Disasm/usb-tester/hardware/usb-tester.kicad_pcb

## KiCad design hardware/usb-tester.kicad_pcb (2020-05-18)

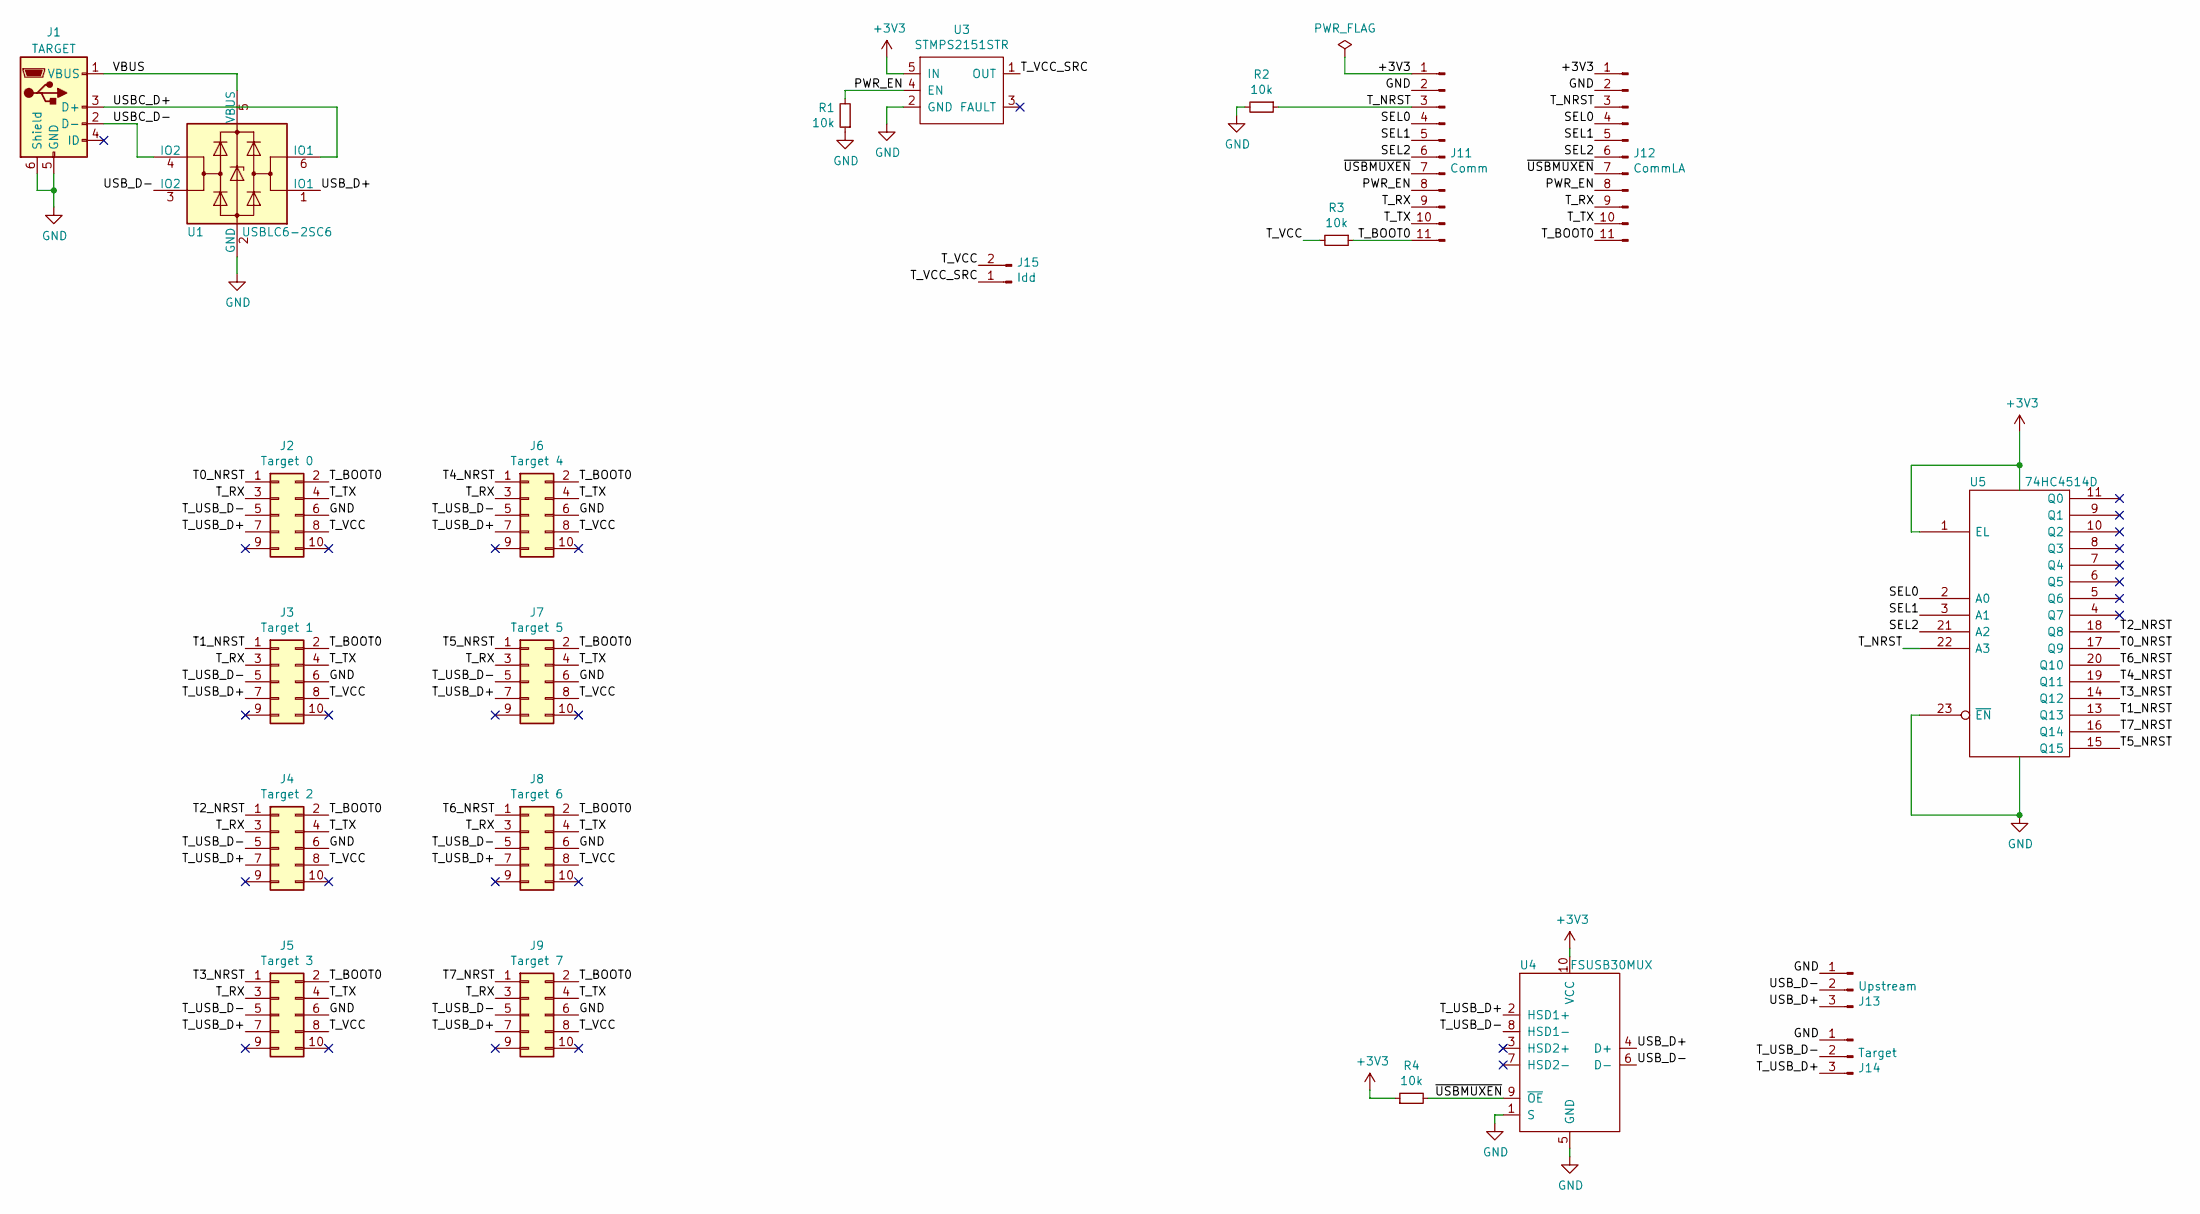
[picture p1: schematic usb-tester.sch]

Parts:
J1: TARGET; USB_Micro-B_Molex-105017-0001
J2: Target 0; PinSocket_2x05_P2.54mm_Vertical_Reversed
J3: Target 1; PinSocket_2x05_P2.54mm_Vertical_Reversed
J4: Target 2; PinSocket_2x05_P2.54mm_Vertical_Reversed
J5: Target 3; PinSocket_2x05_P2.54mm_Vertical_Reversed
J6: Target 4; PinSocket_2x05_P2.54mm_Vertical_Reversed
J7: Target 5; PinSocket_2x05_P2.54mm_Vertical_Reversed
J8: Target 6; PinSocket_2x05_P2.54mm_Vertical_Reversed
J9: Target 7; PinSocket_2x05_P2.54mm_Vertical_Reversed
J11: Comm; PinHeader_1x11_P2.54mm_Vertical
J12: CommLA; PinHeader_1x11_P2.54mm_Vertical
J13: Upstream; PinHeader_1x03_P2.54mm_Vertical
J14: Target; PinHeader_1x03_P2.54mm_Vertical
J15: Idd; PinHeader_1x02_P2.54mm_Vertical
R1, R2, R3, R4: 10k; R_1206_3216Metric_Pad1.42x1.75mm_HandSolder
U1: USBLC6-2SC6; SOT-23-6
U3: STMPS2151STR; SOT-23-5
U4: FSUSB30MUX; MSOP-10_3x3mm_P0.5mm
U5: 74HC4514D; SOIC-24W_7.5x15.4mm_P1.27mm

Connections:
+3V3: J11.1, J12.1, R4.1, U3.5 (IN), U4.10 (VCC), U5.1 (EL), U5.24 (Vdd)
/PWR_EN: J11.8, J12.8, R1.2, U3.4 (EN)
/SEL0: J11.4, J12.4, U5.2 (A0)
/SEL1: J11.5, J12.5, U5.3 (A1)
/SEL2: J11.6, J12.6, U5.21 (A2)
/T0_NRST: J2.1, U5.17 (Q9)
/T1_NRST: J3.1, U5.13 (Q13)
/T2_NRST: J4.1, U5.18 (Q8)
/T3_NRST: J5.1, U5.14 (Q12)
/T4_NRST: J6.1, U5.19 (Q11)
/T5_NRST: J7.1, U5.15 (Q15)
/T6_NRST: J8.1, U5.20 (Q10)
/T7_NRST: J9.1, U5.16 (Q14)
/T_BOOT0: J2.2, J3.2, J4.2, J5.2, J6.2, J7.2, J8.2, J9.2, J11.11, J12.11, R3.1
/T_NRST: J11.3, J12.3, R2.1, U5.22 (A3)
/T_RX: J2.3, J3.3, J4.3, J5.3, J6.3, J7.3, J8.3, J9.3, J11.9, J12.9
/T_TX: J2.4, J3.4, J4.4, J5.4, J6.4, J7.4, J8.4, J9.4, J11.10, J12.10
/T_USB_D+: J2.7, J3.7, J4.7, J5.7, J6.7, J7.7, J8.7, J9.7, J14.3, U4.2 (HSD1+)
/T_USB_D-: J2.5, J3.5, J4.5, J5.5, J6.5, J7.5, J8.5, J9.5, J14.2, U4.8 (HSD1-)
/T_VCC: J2.8, J3.8, J4.8, J5.8, J6.8, J7.8, J8.8, J9.8, J15.2, R3.2
/T_VCC_SRC: J15.1, U3.1 (OUT)
/USBC_D+: J1.3 (D+), U1.6 (IO1)
/USBC_D-: J1.2 (D-), U1.4 (IO2)
/USB_D+: J13.3, U1.1 (IO1), U4.4 (D+)
/USB_D-: J13.2, U1.3 (IO2), U4.6 (D-)
/VBUS: J1.1 (VBUS), U1.5 (VBUS)
/~USBMUXEN: J11.7, J12.7, R4.2, U4.9 (~OE)
GND: J1.5 (GND), J1.6 (Shield), J2.6, J3.6, J4.6, J5.6, J6.6, J7.6, J8.6, J9.6, J11.2, J12.2, J13.1, J14.1, R1.1, R2.2, U1.2 (GND), U3.2 (GND), U4.1 (S), U4.5 (GND), U5.12 (Vss), U5.23 (~EN)

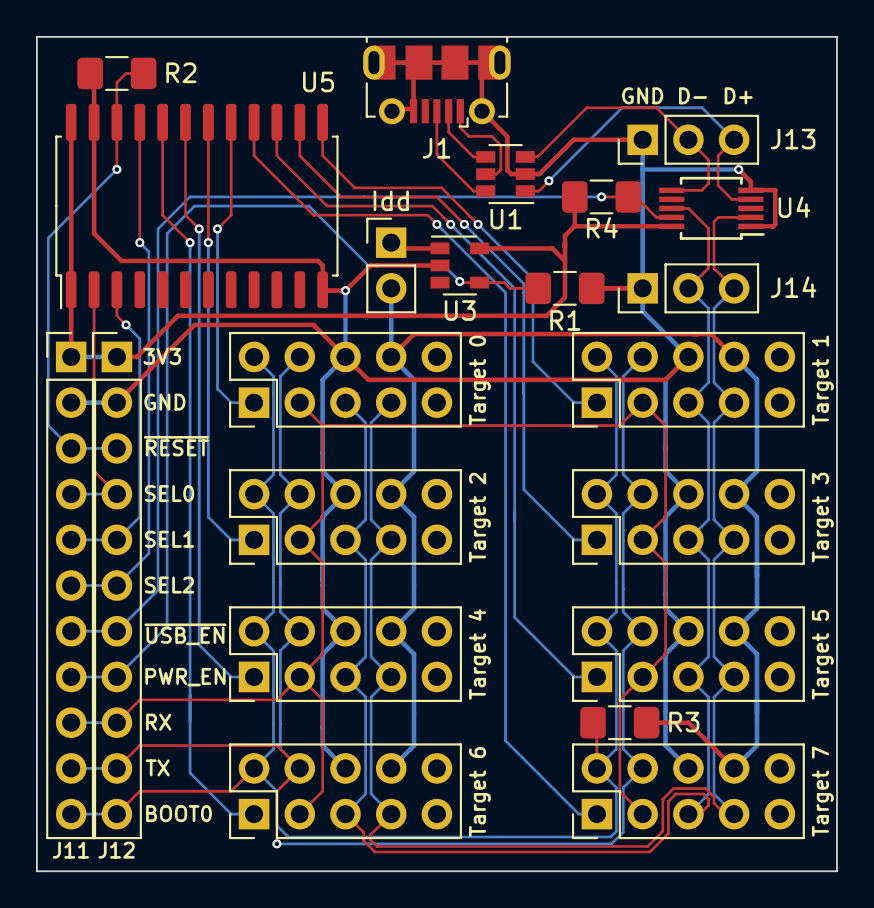
[picture p2: board usb-tester.kicad_pcb from above]

Board: 2 copper layers, 44.5 x 46.4 mm, 22 parts (0 on the bottom side), 28 nets.
