Disasm/usb-tester/hardware/mod-lqfp48.kicad_pcb

## KiCad design hardware/mod-lqfp48.kicad_pcb (2020-02-24)

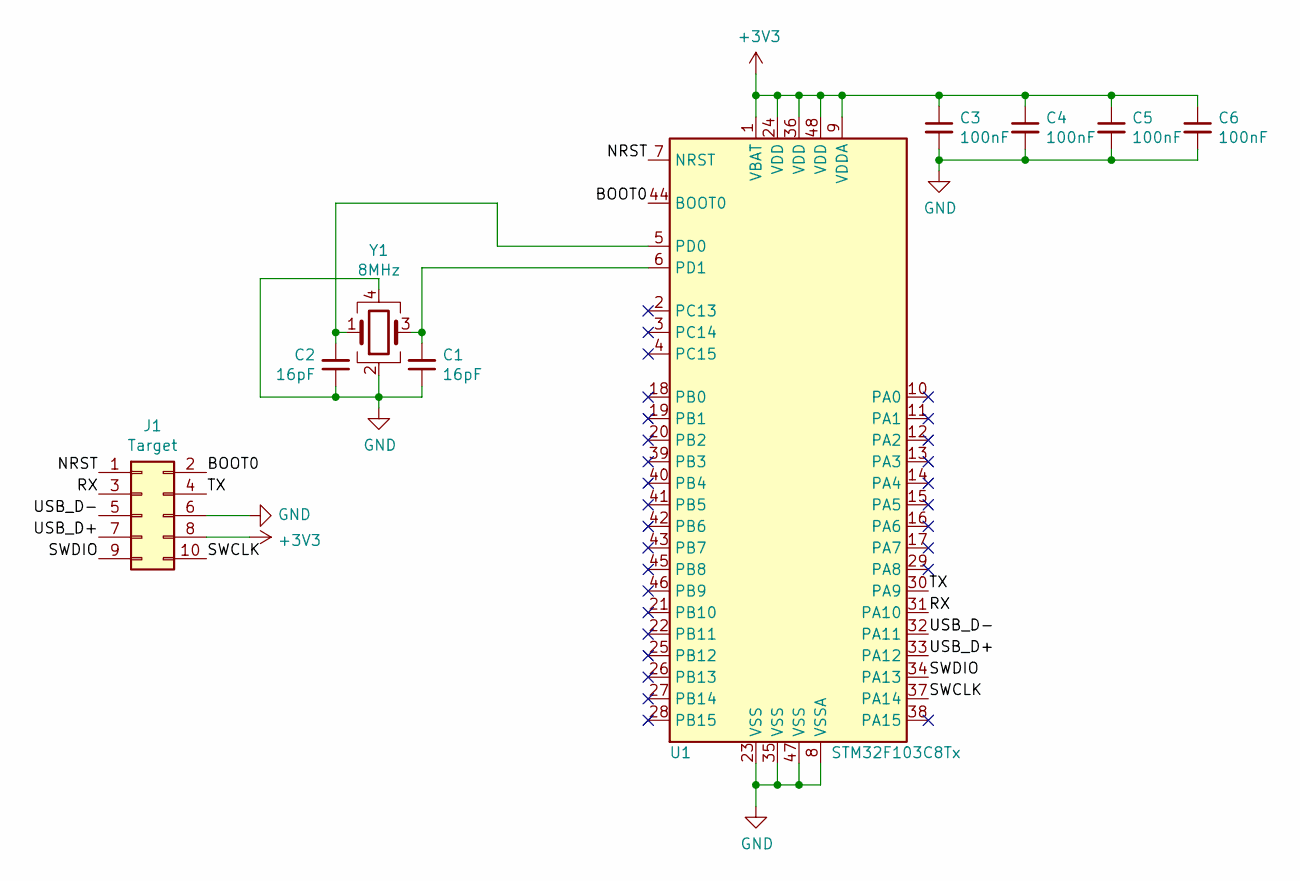
[picture p3: schematic mod-lqfp48.sch]

Parts:
C1, C2: 16pF; C_0805_2012Metric_Pad1.15x1.40mm_HandSolder
C3, C4, C5, C6: 100nF; C_0805_2012Metric_Pad1.15x1.40mm_HandSolder
J1: Target; BH-10-Edge
U1: STM32F103C8Tx; LQFP-48_7x7mm_P0.5mm
Y1: 8MHz; Crystal_SMD_5032-4Pin_5.0x3.2mm

Connections:
+3V3: C3.1, C4.1, C5.1, C6.1, J1.8, U1.1 (VBAT), U1.9 (VDDA), U1.24 (VDD), U1.36 (VDD), U1.48 (VDD)
/BOOT0: J1.2, U1.44 (BOOT0)
/NRST: J1.1, U1.7 (NRST)
/RX: J1.3, U1.31 (PA10)
/SWCLK: J1.10, U1.37 (PA14)
/SWDIO: J1.9, U1.34 (PA13)
/TX: J1.4, U1.30 (PA9)
/USB_D+: J1.7, U1.33 (PA12)
/USB_D-: J1.5, U1.32 (PA11)
GND: C1.1, C2.1, C3.2, C4.2, C5.2, C6.2, J1.6, U1.8 (VSSA), U1.23 (VSS), U1.35 (VSS), U1.47 (VSS), Y1.2, Y1.4
unnamed: C1.2, U1.6 (PD1), Y1.3
unnamed: C2.2, U1.5 (PD0), Y1.1

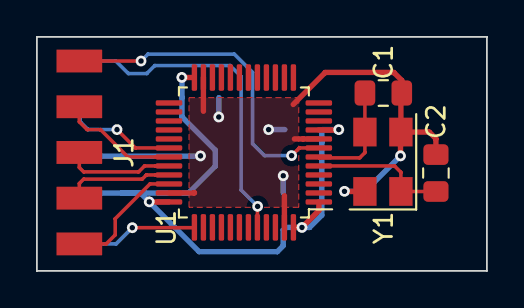
[picture p4: board mod-lqfp48.kicad_pcb from above]

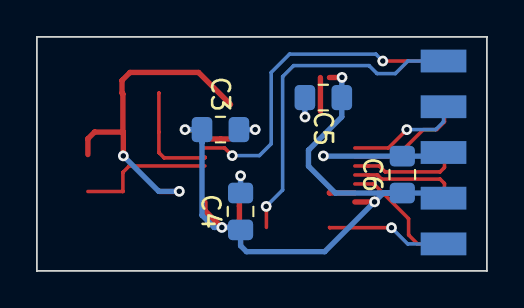
[picture p5: board mod-lqfp48.kicad_pcb from below]

Board: 2 copper layers, 25.0 x 13.0 mm, 9 parts (4 on the bottom side), 12 nets.
