Disasm/usb-tester/hardware/mod-lqfp64.kicad_pcb

## KiCad design hardware/mod-lqfp64.kicad_pcb (2020-02-24)

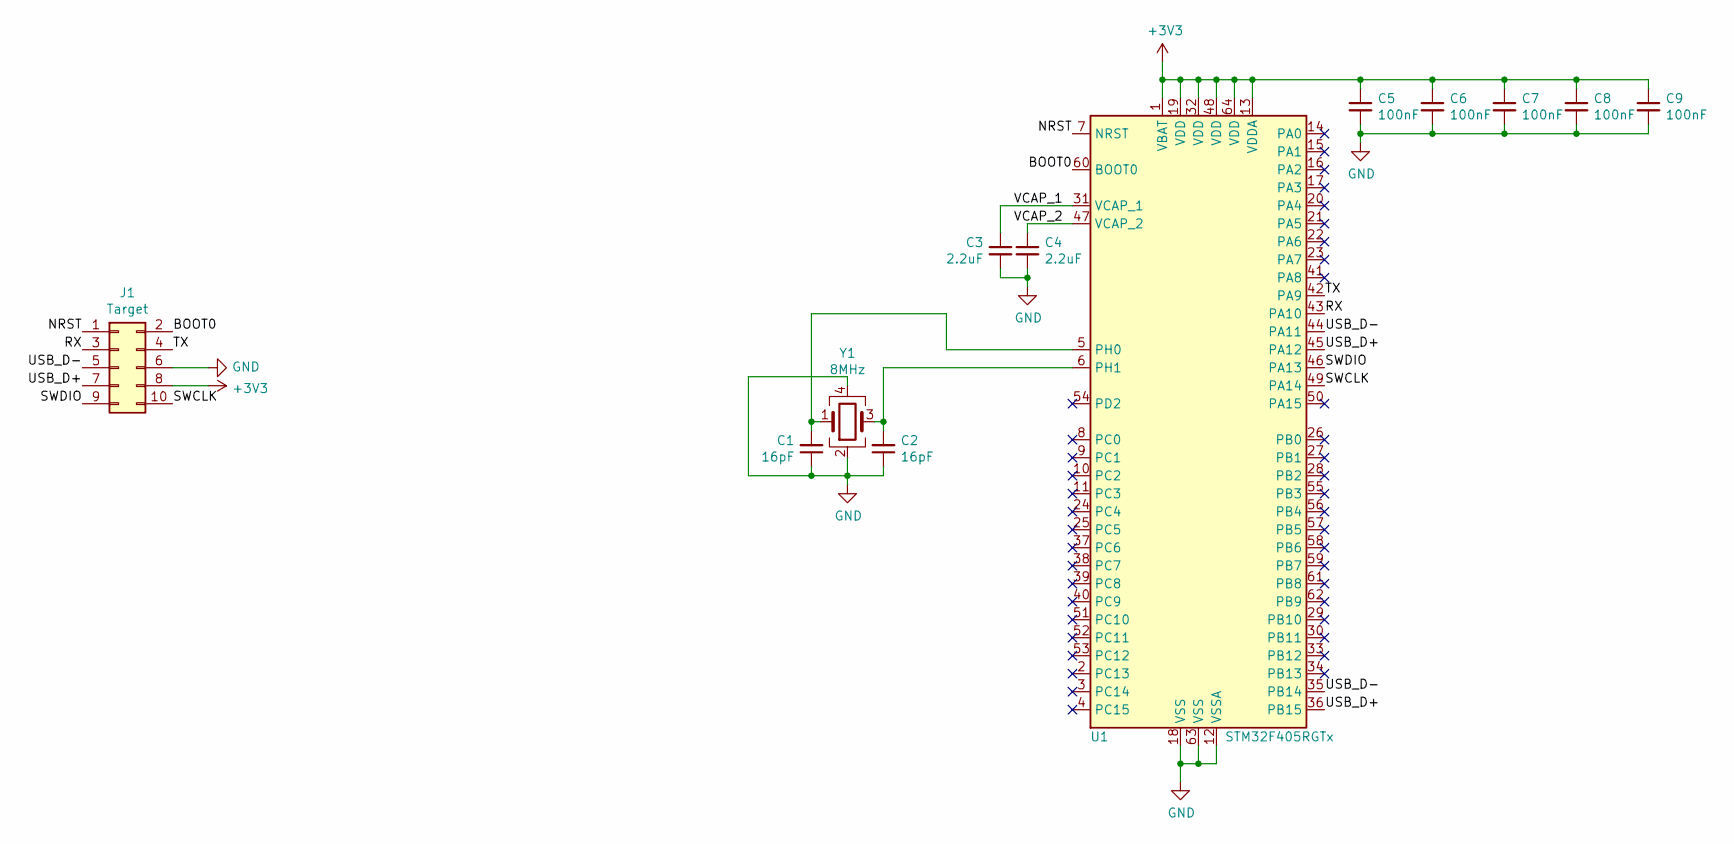
[picture p6: schematic mod-lqfp64.sch]

Parts:
C1, C2: 16pF; C_0805_2012Metric_Pad1.15x1.40mm_HandSolder
C3, C4: 2.2uF; C_0805_2012Metric_Pad1.15x1.40mm_HandSolder
C5, C6, C7, C8, C9: 100nF; C_0805_2012Metric_Pad1.15x1.40mm_HandSolder
J1: Target; BH-10-Edge
U1: STM32F405RGTx; LQFP-64_10x10mm_P0.5mm
Y1: 8MHz; Crystal_SMD_5032-4Pin_5.0x3.2mm

Connections:
+3V3: C5.1, C6.1, C7.1, C8.1, C9.1, J1.8, U1.1 (VBAT), U1.13 (VDDA), U1.19 (VDD), U1.32 (VDD), U1.48 (VDD), U1.64 (VDD)
/BOOT0: J1.2, U1.60 (BOOT0)
/NRST: J1.1, U1.7 (NRST)
/RX: J1.3, U1.43 (PA10)
/SWCLK: J1.10, U1.49 (PA14)
/SWDIO: J1.9, U1.46 (PA13)
/TX: J1.4, U1.42 (PA9)
/USB_D+: J1.7, U1.36 (PB15), U1.45 (PA12)
/USB_D-: J1.5, U1.35 (PB14), U1.44 (PA11)
/VCAP_1: C3.1, U1.31 (VCAP_1)
/VCAP_2: C4.1, U1.47 (VCAP_2)
GND: C1.1, C2.1, C3.2, C4.2, C5.2, C6.2, C7.2, C8.2, C9.2, J1.6, U1.12 (VSSA), U1.18 (VSS), U1.63 (VSS), Y1.2, Y1.4
unnamed: C1.2, U1.5 (PH0), Y1.1
unnamed: C2.2, U1.6 (PH1), Y1.3

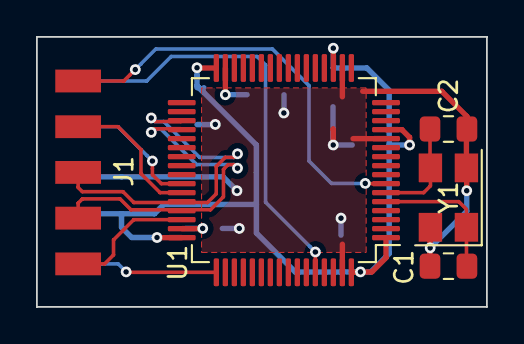
[picture p7: board mod-lqfp64.kicad_pcb from above]

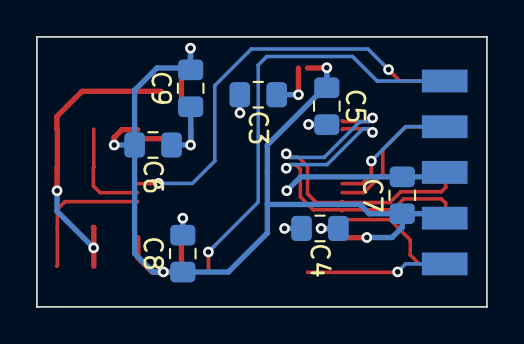
[picture p8: board mod-lqfp64.kicad_pcb from below]

Board: 2 copper layers, 25.0 x 15.0 mm, 12 parts (7 on the bottom side), 14 nets.
