Disasm/usb-tester/(commit log)

2020-02-06 WIP hardware
    [usb-tester.sch]
2020-02-06 Move symbols to 'ic' library
    [usb-tester.sch]
2020-02-11 Base board
    [usb-tester.sch]
2020-02-11 mod-lqfp48 board WIP
    [mod-lqfp48.kicad_pcb, mod-lqfp48.sch]
2020-02-12 mod-lqfp48 board schematic finished
    [mod-lqfp48.sch]
2020-02-19 mod-lqfp48 is finally routed
    [mod-lqfp48.kicad_pcb, mod-lqfp48.sch]
2020-02-19 mod-lqfp64 schematic
    [mod-lqfp64.sch]
2020-02-19 mod-lqfp64 board layout
    [mod-lqfp64.kicad_pcb, mod-lqfp64.sch]
2020-02-19 Rotate references
    [mod-lqfp48.kicad_pcb, mod-lqfp64.kicad_pcb]
2020-02-20 Updated connectors and labels on the main board
    [usb-tester.sch]
2020-02-20 Main board schematic
    [usb-tester.sch]
2020-02-20 WIP main board
    [usb-tester.kicad_pcb, usb-tester.sch]
2020-02-20 Use separate USBSEL signal for USB switches
    [usb-tester.sch]
2020-02-22 WIP main board layout
    [usb-tester.kicad_pcb, usb-tester.sch]
2020-02-24 Use the same net for FS and HS USB
    [mod-lqfp64.sch]
2020-02-24 Update mod-lqfp64 board layout
    [mod-lqfp64.kicad_pcb]
2020-02-24 Fix DRC warnings in mod-lqfp48
    [mod-lqfp48.kicad_pcb]
2020-02-24 Move labels
    [mod-lqfp64.kicad_pcb]
2020-02-24 Use Rezonit solder mask parameters
    [mod-lqfp48.kicad_pcb, mod-lqfp64.kicad_pcb]
2020-02-24 Align boards to the 1mm grid
    [mod-lqfp48.kicad_pcb, mod-lqfp64.kicad_pcb]
2020-02-24 Resize the mod-lqfp48 board
    [mod-lqfp48.kicad_pcb]
2020-03-03 Add gerber files for mod-lqfp48 and mod-lqfp64
    [mod-lqfp48.DRL, mod-lqfp48.GBL, mod-lqfp48.GBO, mod-lqfp48.GBS, mod-lqfp48.GKO, mod-lqfp48.GTL, mod-lqfp48.GTO, mod-lqfp48.GTS]
2020-03-05 Open serial port component of the usb switch
2020-04-06 Simplify schematics, add WIP layout
    [usb-tester.kicad_pcb, usb-tester.sch]
2020-05-17 Finalize shematics and layout
    [usb-tester.kicad_pcb, usb-tester.sch]
2020-05-17 Fix ERC errors
    [usb-tester.sch]
2020-05-17 Re-import netlist
    [usb-tester.kicad_pcb]
2020-05-17 Update design rules
    [usb-tester.kicad_pcb]
2020-05-18 Update KiCad libraries
2020-05-18 Use reversed footprint instead of a standard one
    [usb-tester.sch]
2020-05-18 Update layout
    [usb-tester.kicad_pcb]
2020-05-18 Add labels
    [usb-tester.kicad_pcb]
2020-05-18 Tune silkscreen params a little bit
    [usb-tester.kicad_pcb]
2020-05-18 Add gerbers for the usb-tester board
    [usb-tester-B_Cu.gbr, usb-tester-B_Mask.gbr, usb-tester-B_SilkS.gbr, usb-tester-Edge_Cuts.gbr, usb-tester-F_Cu.gbr, usb-tester-F_Mask.gbr, usb-tester-F_SilkS.gbr, usb-tester.drl]
2020-05-24 Perform poweroff cycle before talking to a bootloader
2020-05-24 Decode device id
2020-05-24 Use eprintln for errors
    [main.rs]
2020-05-24 Do not keep NRST and BOOT0 lines high during powerdown
